yagizkorkmaz/hydration-wearable/hardware/bitirme2.kicad_pcb

## KiCad design hardware/bitirme2.kicad_pcb (2026-10-11)

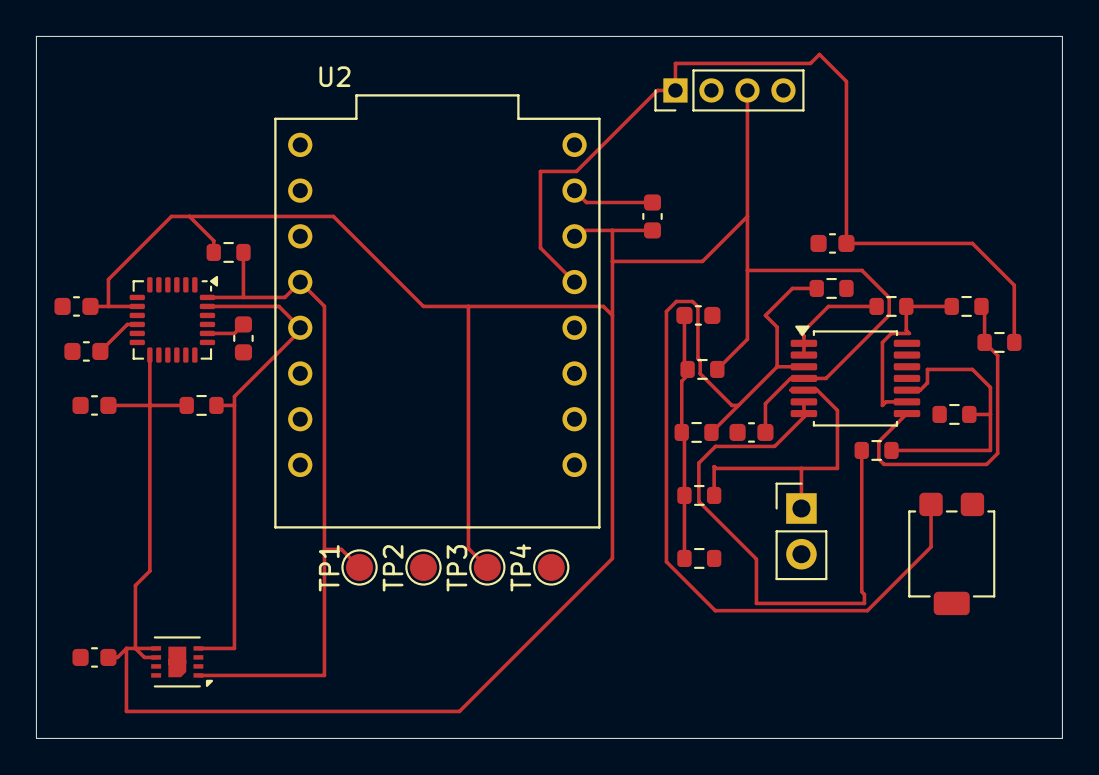
[picture p3: board bitirme2.kicad_pcb from above]

Board: 2 copper layers, 57.0 x 39.0 mm, 32 parts (0 on the bottom side), 15 nets.

Parts:
C1, C2, C3, C4, C9: 100nF; C_0603_1608Metric
C5: 2.2nF; C_0603_1608Metric
C6, C7: 100n; C_0603_1608Metric
C8: 4.7µF; C_0603_1608Metric
J1: JST 2.0; PinHeader_1x02_P2.54mm_Vertical
J3: SMD Grove; PinHeader_1x04_P2.00mm_Vertical
R1: 200K; Potentiometer_Bourns_3314G_Vertical
R2, R7, R12, R13: 4.7K; R_0603_1608Metric
R3: DNP; R_0603_1608Metric
R4, R5, R6, R11: 200K; R_0603_1608Metric
R8, R10: 100k; R_0603_1608Metric
R9: 1M; R_0603_1608Metric
TP1, TP2, TP3, TP4: TestPoint; TestPoint_Pad_D1.5mm
U1: LM324PW-TSSOP14; TSSOP-14_4.4x5mm_P0.65mm
U2: ESP32_C3_Super_Mini; MODULE_ESP32-C3_SUPERMINI_TH
U3: SHT30-DIS; Sensirion_DFN-8-1EP_2.5x2.5mm_P0.5mm_EP1.1x1.7mm
U4: MPU-6050; InvenSense_QFN-24_4x4mm_P0.5mm

Connections:
/GND: C1.1, C2.1, C3.1, C4.2, C5.2, C6.2, C7.1, C8.1, C9.1, J1.2, J3.4, R1.2 (3), R3.2, R7.1, R11.1, TP4.1 (1_1), U1.11 (V-), U2.G, U3.2 (ADDR), U3.8 (VSS), U3.9 (VSS), U4.1 (CLKIN), U4.9 (AD0), U4.11 (FSYNC), U4.18 (GND)
/SCL: R13.2, TP2.1 (1_1), U2.9 (GPIO9), U3.4 (SCL), U4.23 (SCL)
/SDA: R12.2, TP1.1 (1_1), U2.8 (GPIO8), U3.1 (SDA), U4.24 (SDA)
/SIG: C2.2, J3.1, R9.2, U2.4 (GPIO4)
/VCC: C3.2, C6.1, C7.2, C8.2, C9.2, J3.3, R2.2, R12.1, R13.1, TP3.1 (1_1), U1.4 (V+), U2.3.3, U3.5 (VDD), U3.6 (~RESET), U4.8 (VLOGIC), U4.13 (VDD)
unnamed: C1.2, R2.1, R5.1, R6.1, R7.2
unnamed: J1.1, R6.2, U1.5 (IN+)
unnamed: R1.3 (2), R3.1, R5.2, U1.3 (IN+)
unnamed: R8.1, U1.1 (OUT), U1.2 (IN-)
unnamed: R10.2, R11.2, U1.10 (IN+)
unnamed: R4.1, R8.2, U1.9 (IN-)
unnamed: R4.2, R9.1, U1.8 (OUT)
unnamed: R10.1, U1.6 (IN-), U1.7 (OUT)
unnamed: C5.1, U4.20 (CPOUT)
unnamed: C4.1, U4.10 (REGOUT)
